Tobbisch/Brewnode/README.md

# Brewnode
Cheap IO node for taking in values to a Siemens PLC
