Tobbisch/Brewnode/Brewnode_PCB/Brewnode_PCB.csv

Source: | C:\Program Files\KiCad\share\kicad\Brewnode\Brewnode_PCB\Brewnode_PCB.sch
Date: | 2020-09-22 17:36:48
Tool: | Eeschema (5.1.6)-1
Generator: | C:\Program Files\KiCad\bin\scripting\plugins/bom_csv_grouped_by_value.py
Component Count: | 83
Individual Components:
Item | Qty | Reference(s) | Value | LibPart | Footprint | Datasheet | LCSC | Mfc
 |  | C1 | 100nF | Device:C | Capacitor_SMD:C_0402_1005Metric | https://datasheet.lcsc.com/szlcsc/1810191219_Samsung-Electro-Mechanics-CL05B104KO5NNNC_C1525.pdf | C1525 | CL05B104KO5NNNC
 |  | C2 | 47uF | Device:C_Polarized | Capacitor_SMD:CP_Elec_6.3x5.3 | https://datasheet.lcsc.com/szlcsc/1912111437_Lelon-VEZ470M1CTR-0605_C249778.pdf | C249778 | VEZ470M1CTR-0605
 |  | C3 | 220uF | Device:C_Polarized | Capacitor_SMD:CP_Elec_8x10 | https://datasheet.lcsc.com/szlcsc/1912111437_Lelon-VUA221M1ATR-0810_C249801.pdf | C249801 | VUA221M1ATR-0810
 |  | C4 | 100nF | Device:C | Capacitor_SMD:C_0402_1005Metric | https://datasheet.lcsc.com/szlcsc/1810191219_Samsung-Electro-Mechanics-CL05B104KO5NNNC_C1525.pdf | C1525 | CL05B104KO5NNNC
 |  | C5 | 47uF | Device:C_Polarized | Capacitor_SMD:CP_Elec_6.3x5.3 | https://datasheet.lcsc.com/szlcsc/1912111437_Lelon-VEZ470M1CTR-0605_C249778.pdf | C249778 | VEZ470M1CTR-0605
 |  | C6 | 47uF | Device:C_Polarized | Capacitor_SMD:CP_Elec_6.3x5.3 | https://datasheet.lcsc.com/szlcsc/1912111437_Lelon-VEZ470M1CTR-0605_C249778.pdf | C249778 | VEZ470M1CTR-0605
 |  | D1 | LED_1206 | Device:LED | LED_SMD:LED_1206_3216Metric | https://datasheet.lcsc.com/szlcsc/1810231512_Lite-On-LTST-C150KGKT_C125085.pdf | C125085 | LTST-C150KGKT
 |  | D2 | LED_1206 | Device:LED | LED_SMD:LED_1206_3216Metric | https://datasheet.lcsc.com/szlcsc/1810231512_Lite-On-LTST-C150KGKT_C125085.pdf | C125085 | LTST-C150KGKT
 |  | D3 | SMA | Device:D | Diode_SMD:D_SMA-SMB_Universal_Handsoldering | https://datasheet.lcsc.com/szlcsc/1810311713_MDD-Microdiode-Electronics-M7_C95872.pdf | C95872 | M7
 |  | D4 | SMA | Device:D | Diode_SMD:D_SMA-SMB_Universal_Handsoldering | https://datasheet.lcsc.com/szlcsc/1810311713_MDD-Microdiode-Electronics-M7_C95872.pdf | C95872 | M7
 |  | D5 | SMA | Device:D | Diode_SMD:D_SMA-SMB_Universal_Handsoldering | https://datasheet.lcsc.com/szlcsc/1810311713_MDD-Microdiode-Electronics-M7_C95872.pdf | C95872 | M7
 |  | D6 | SMA | Device:D | Diode_SMD:D_SMA-SMB_Universal_Handsoldering | https://datasheet.lcsc.com/szlcsc/1810311713_MDD-Microdiode-Electronics-M7_C95872.pdf | C95872 | M7
 |  | F1 | 500mA | Device:Polyfuse_Small | Fuse:Fuse_0402_1005Metric | https://datasheet.lcsc.com/szlcsc/1808141123_Littelfuse-0435-500KRHF_C206945.pdf | C206945 | 0435.500KRHF
 |  | F2 | 500mA | Device:Polyfuse_Small | Fuse:Fuse_0402_1005Metric | https://datasheet.lcsc.com/szlcsc/1808141123_Littelfuse-0435-500KRHF_C206945.pdf | C206945 | 0435.500KRHF
 |  | J1 | Screw_Terminal_01x03 | Connector:Screw_Terminal_01x03 | Connector_Phoenix_MSTB:PhoenixContact_MSTBA_2,5_3-G-5,08_1x03_P5.08mm_Horizontal | https://datasheet.lcsc.com/szlcsc/1912251632_Ningbo-Kangnex-Elec-WJ2EDGRC-5-08-3P_C8377.pdf | C8377 | WJ2EDGRC-5.08-3P
 |  | J2 | Screw_Terminal_01x03 | Connector:Screw_Terminal_01x03 | Connector_Phoenix_MSTB:PhoenixContact_MSTBA_2,5_3-G-5,08_1x03_P5.08mm_Horizontal | https://datasheet.lcsc.com/szlcsc/1912251632_Ningbo-Kangnex-Elec-WJ2EDGRC-5-08-3P_C8377.pdf | C8377 | WJ2EDGRC-5.08-3P
 |  | J3 | Screw_Terminal_01x03 | Connector:Screw_Terminal_01x03 | Connector_Phoenix_MSTB:PhoenixContact_MSTBVA_2,5_3-G-5,08_1x03_P5.08mm_Vertical | https://datasheet.lcsc.com/szlcsc/1912251634_Ningbo-Kangnex-Elec-WJ2EDGVC-5-08-3P_C8412.pdf | C8412 | WJ2EDGVC-5.08-3P
 |  | J4 | Screw_Terminal_01x03 | Connector:Screw_Terminal_01x03 | Connector_Phoenix_MSTB:PhoenixContact_MSTBVA_2,5_3-G-5,08_1x03_P5.08mm_Vertical | https://datasheet.lcsc.com/szlcsc/1912251634_Ningbo-Kangnex-Elec-WJ2EDGVC-5-08-3P_C8412.pdf | C8412 | WJ2EDGVC-5.08-3P
 |  | J5 | Screw_Terminal_01x03 | Connector:Screw_Terminal_01x03 | Connector_Phoenix_MSTB:PhoenixContact_MSTBA_2,5_3-G-5,08_1x03_P5.08mm_Horizontal | https://datasheet.lcsc.com/szlcsc/1912251632_Ningbo-Kangnex-Elec-WJ2EDGRC-5-08-3P_C8377.pdf | C8377 | WJ2EDGRC-5.08-3P
 |  | J6 | Screw_Terminal_01x03 | Connector:Screw_Terminal_01x03 | Connector_Phoenix_MSTB:PhoenixContact_MSTBA_2,5_3-G-5,08_1x03_P5.08mm_Horizontal | https://datasheet.lcsc.com/szlcsc/1912251632_Ningbo-Kangnex-Elec-WJ2EDGRC-5-08-3P_C8377.pdf | C8377 | WJ2EDGRC-5.08-3P
 |  | J7 | Screw_Terminal_01x03 | Connector:Screw_Terminal_01x03 | Connector_Phoenix_MSTB:PhoenixContact_MSTBA_2,5_3-G-5,08_1x03_P5.08mm_Horizontal | https://datasheet.lcsc.com/szlcsc/1912251632_Ningbo-Kangnex-Elec-WJ2EDGRC-5-08-3P_C8377.pdf | C8377 | WJ2EDGRC-5.08-3P
 |  | J8 | Screw_Terminal_01x03 | Connector:Screw_Terminal_01x03 | Connector_Phoenix_MSTB:PhoenixContact_MSTBA_2,5_3-G-5,08_1x03_P5.08mm_Horizontal | https://datasheet.lcsc.com/szlcsc/1912251632_Ningbo-Kangnex-Elec-WJ2EDGRC-5-08-3P_C8377.pdf | C8377 | WJ2EDGRC-5.08-3P
 |  | J9 | Screw_Terminal_01x03 | Connector:Screw_Terminal_01x03 | Connector_Phoenix_MSTB:PhoenixContact_MSTBA_2,5_3-G-5,08_1x03_P5.08mm_Horizontal | https://datasheet.lcsc.com/szlcsc/1912251632_Ningbo-Kangnex-Elec-WJ2EDGRC-5-08-3P_C8377.pdf | C8377 | WJ2EDGRC-5.08-3P
 |  | J10 | Screw_Terminal_01x03 | Connector:Screw_Terminal_01x03 | Connector_Phoenix_MSTB:PhoenixContact_MSTBA_2,5_3-G-5,08_1x03_P5.08mm_Horizontal | https://datasheet.lcsc.com/szlcsc/1912251632_Ningbo-Kangnex-Elec-WJ2EDGRC-5-08-3P_C8377.pdf | C8377 | WJ2EDGRC-5.08-3P
 |  | J11 | Screw_Terminal_01x03 | Connector:Screw_Terminal_01x03 | Connector_Phoenix_MSTB:PhoenixContact_MSTBVA_2,5_3-G-5,08_1x03_P5.08mm_Vertical | https://datasheet.lcsc.com/szlcsc/1912251634_Ningbo-Kangnex-Elec-WJ2EDGVC-5-08-3P_C8412.pdf | C8412 | WJ2EDGVC-5.08-3P
 |  | J12 | Screw_Terminal_01x03 | Connector:Screw_Terminal_01x03 | Connector_Phoenix_MSTB:PhoenixContact_MSTBVA_2,5_3-G-5,08_1x03_P5.08mm_Vertical | https://datasheet.lcsc.com/szlcsc/1912251634_Ningbo-Kangnex-Elec-WJ2EDGVC-5-08-3P_C8412.pdf | C8412 | WJ2EDGVC-5.08-3P
 |  | J13 | Screw_Terminal_01x03 | Connector:Screw_Terminal_01x03 | Connector_Phoenix_MSTB:PhoenixContact_MSTBA_2,5_3-G-5,08_1x03_P5.08mm_Horizontal | https://datasheet.lcsc.com/szlcsc/1912251632_Ningbo-Kangnex-Elec-WJ2EDGRC-5-08-3P_C8377.pdf | C8377 | WJ2EDGRC-5.08-3P
 |  | J14 | Screw_Terminal_01x03 | Connector:Screw_Terminal_01x03 | Connector_Phoenix_MSTB:PhoenixContact_MSTBA_2,5_3-G-5,08_1x03_P5.08mm_Horizontal | https://datasheet.lcsc.com/szlcsc/1912251632_Ningbo-Kangnex-Elec-WJ2EDGRC-5-08-3P_C8377.pdf | C8377 | WJ2EDGRC-5.08-3P
 |  | J15 | Screw_Terminal_01x03 | Connector:Screw_Terminal_01x03 | Connector_Phoenix_MSTB:PhoenixContact_MSTBVA_2,5_3-G-5,08_1x03_P5.08mm_Vertical | https://datasheet.lcsc.com/szlcsc/1912251634_Ningbo-Kangnex-Elec-WJ2EDGVC-5-08-3P_C8412.pdf | C8412 | WJ2EDGVC-5.08-3P
 |  | J16 | Screw_Terminal_01x03 | Connector:Screw_Terminal_01x03 | Connector_Phoenix_MSTB:PhoenixContact_MSTBVA_2,5_3-G-5,08_1x03_P5.08mm_Vertical | https://datasheet.lcsc.com/szlcsc/1912251634_Ningbo-Kangnex-Elec-WJ2EDGVC-5-08-3P_C8412.pdf | C8412 | WJ2EDGVC-5.08-3P
 |  | J17 | 16p FPC | Connector_Generic:Conn_01x16 | Connector_FFC-FPC:Hirose_FH34_FPC_16 | https://datasheet.lcsc.com/szlcsc/1811071030_HRS-Hirose-FH34SRJ-16S-0-5SH-50_C324725.pdf | C324725 | FH34SRJ-16S-0.5SH(50)
 |  | JP1 | Jumper_2_Open | Jumper:Jumper_2_Open | Connector_PinHeader_2.54mm:PinHeader_1x02_P2.54mm_Vertical | ~
 |  | JP2 | Jumper_2_Open | Jumper:Jumper_2_Open | Connector_PinHeader_2.54mm:PinHeader_1x02_P2.54mm_Vertical | ~
 |  | JP3 | Jumper_2_Open | Jumper:Jumper_2_Open | Connector_PinHeader_2.54mm:PinHeader_1x02_P2.54mm_Vertical | ~
 |  | JP4 | Jumper_2_Open | Jumper:Jumper_2_Open | Connector_PinHeader_2.54mm:PinHeader_1x02_P2.54mm_Vertical | ~
 |  | JP5 | Jumper_2_Open | Jumper:Jumper_2_Open | Connector_PinHeader_2.54mm:PinHeader_1x02_P2.54mm_Vertical | ~
 |  | JP6 | Jumper_2_Open | Jumper:Jumper_2_Open | Connector_PinHeader_2.54mm:PinHeader_1x02_P2.54mm_Vertical | ~
 |  | JP7 | Jumper_2_Open | Jumper:Jumper_2_Open | Connector_PinHeader_2.54mm:PinHeader_1x02_P2.54mm_Vertical | ~
 |  | JP8 | Jumper_2_Open | Jumper:Jumper_2_Open | Connector_PinHeader_2.54mm:PinHeader_1x02_P2.54mm_Vertical | ~
 |  | K1 | SANYOU_SRD_Form_C | Relay:SANYOU_SRD_Form_C | Relay_THT:Relay_SPDT_SANYOU_SRD_Series_Form_C | https://datasheet.lcsc.com/szlcsc/1811021933_Ningbo-Songle-Relay-SRD-05VDC-SL-C_C35449.pdf | C35449 | SRD-05VDC-SL-C
 |  | K2 | SANYOU_SRD_Form_C | Relay:SANYOU_SRD_Form_C | Relay_THT:Relay_SPDT_SANYOU_SRD_Series_Form_C | https://datasheet.lcsc.com/szlcsc/1811021933_Ningbo-Songle-Relay-SRD-05VDC-SL-C_C35449.pdf | C35449 | SRD-05VDC-SL-C
 |  | K3 | SANYOU_SRD_Form_C | Relay:SANYOU_SRD_Form_C | Relay_THT:Relay_SPDT_SANYOU_SRD_Series_Form_C | https://datasheet.lcsc.com/szlcsc/1811021933_Ningbo-Songle-Relay-SRD-05VDC-SL-C_C35449.pdf | C35449 | SRD-05VDC-SL-C
 |  | K4 | SANYOU_SRD_Form_C | Relay:SANYOU_SRD_Form_C | Relay_THT:Relay_SPDT_SANYOU_SRD_Series_Form_C | https://datasheet.lcsc.com/szlcsc/1811021933_Ningbo-Songle-Relay-SRD-05VDC-SL-C_C35449.pdf | C35449 | SRD-05VDC-SL-C
 |  | Q1 | FDN340P | Transistor_FET:FDN340P | Package_TO_SOT_SMD:SOT-23 | https://www.onsemi.com/pub/Collateral/FDN340P-D.PDF | C75469 | FDN340P
 |  | Q2 | FDN340P | Transistor_FET:FDN340P | Package_TO_SOT_SMD:SOT-23 | https://www.onsemi.com/pub/Collateral/FDN340P-D.PDF | C75469 | FDN340P
 |  | Q3 | FDN340P | Transistor_FET:FDN340P | Package_TO_SOT_SMD:SOT-23 | https://www.onsemi.com/pub/Collateral/FDN340P-D.PDF | C75469 | FDN340P
 |  | Q4 | FDN340P | Transistor_FET:FDN340P | Package_TO_SOT_SMD:SOT-23 | https://www.onsemi.com/pub/Collateral/FDN340P-D.PDF | C75469 | FDN340P
 |  | Q5 | BSS138 | Transistor_FET:BSS138 | Package_TO_SOT_SMD:SOT-23 | https://www.onsemi.com/pub/Collateral/BSS138-D.PDF | C52895 | BSS138
 |  | Q6 | BSS138 | Transistor_FET:BSS138 | Package_TO_SOT_SMD:SOT-23 | https://www.onsemi.com/pub/Collateral/BSS138-D.PDF | C52895 | BSS138
 |  | Q7 | BSS138 | Transistor_FET:BSS138 | Package_TO_SOT_SMD:SOT-23 | https://www.onsemi.com/pub/Collateral/BSS138-D.PDF | C52895 | BSS138
 |  | Q8 | BSS138 | Transistor_FET:BSS138 | Package_TO_SOT_SMD:SOT-23 | https://www.onsemi.com/pub/Collateral/BSS138-D.PDF | C52895 | BSS138
 |  | R1 | 220Ohm | Device:R | Resistor_SMD:R_0805_2012Metric_Pad1.15x1.40mm_HandSolder | https://datasheet.lcsc.com/szlcsc/1810241809_UNI-ROYAL-Uniroyal-Elec-0805W8F2200T5E_C17557.pdf | C17557 | 0805W8F2200T5E
 |  | R2 | 100Ohm | Device:R | Resistor_SMD:R_0805_2012Metric_Pad1.15x1.40mm_HandSolder | https://datasheet.lcsc.com/szlcsc/1809062111_UNI-ROYAL-Uniroyal-Elec-0805W8F1000T5E_C17408.pdf | C17408 | 0805W8F1000T5E
 |  | R3 | 10kOhm | Device:R | Resistor_SMD:R_0805_2012Metric_Pad1.15x1.40mm_HandSolder | https://datasheet.lcsc.com/szlcsc/1810271610_UNI-ROYAL-Uniroyal-Elec-0805W8F1002T5E_C17414.pdf | C17414 | 0805W8F1002T5E
 |  | R4 | 10kOhm | Device:R | Resistor_SMD:R_0805_2012Metric_Pad1.15x1.40mm_HandSolder | https://datasheet.lcsc.com/szlcsc/1810271610_UNI-ROYAL-Uniroyal-Elec-0805W8F1002T5E_C17414.pdf | C17414 | 0805W8F1002T5E
 |  | R5 | 10kOhm | Device:R | Resistor_SMD:R_0805_2012Metric_Pad1.15x1.40mm_HandSolder | https://datasheet.lcsc.com/szlcsc/1810271610_UNI-ROYAL-Uniroyal-Elec-0805W8F1002T5E_C17414.pdf | C17414 | 0805W8F1002T5E
 |  | R6 | 10kOhm | Device:R | Resistor_SMD:R_0805_2012Metric_Pad1.15x1.40mm_HandSolder | https://datasheet.lcsc.com/szlcsc/1810271610_UNI-ROYAL-Uniroyal-Elec-0805W8F1002T5E_C17414.pdf | C17414 | 0805W8F1002T5E
 |  | R7 | 8.2kOhm | Device:R | Resistor_SMD:R_0805_2012Metric_Pad1.15x1.40mm_HandSolder | https://datasheet.lcsc.com/szlcsc/1912111437_UNI-ROYAL-Uniroyal-Elec-0805W8D8201T5E_C407435.pdf | C407435 | 0805W8D8201T5E
 |  | R8 | 8.2kOhm | Device:R | Resistor_SMD:R_0805_2012Metric_Pad1.15x1.40mm_HandSolder | https://datasheet.lcsc.com/szlcsc/1912111437_UNI-ROYAL-Uniroyal-Elec-0805W8D8201T5E_C407435.pdf | C407435 | 0805W8D8201T5E
 |  | R9 | 8.2kOhm | Device:R | Resistor_SMD:R_0805_2012Metric_Pad1.15x1.40mm_HandSolder | https://datasheet.lcsc.com/szlcsc/1912111437_UNI-ROYAL-Uniroyal-Elec-0805W8D8201T5E_C407435.pdf | C407435 | 0805W8D8201T5E
 |  | R10 | 8.2kOhm | Device:R | Resistor_SMD:R_0805_2012Metric_Pad1.15x1.40mm_HandSolder | https://datasheet.lcsc.com/szlcsc/1912111437_UNI-ROYAL-Uniroyal-Elec-0805W8D8201T5E_C407435.pdf | C407435 | 0805W8D8201T5E
 |  | R11 | 8.2kOhm | Device:R | Resistor_SMD:R_0805_2012Metric_Pad1.15x1.40mm_HandSolder | https://datasheet.lcsc.com/szlcsc/1912111437_UNI-ROYAL-Uniroyal-Elec-0805W8D8201T5E_C407435.pdf | C407435 | 0805W8D8201T5E
 |  | R12 | 8.2kOhm | Device:R | Resistor_SMD:R_0805_2012Metric_Pad1.15x1.40mm_HandSolder | https://datasheet.lcsc.com/szlcsc/1912111437_UNI-ROYAL-Uniroyal-Elec-0805W8D8201T5E_C407435.pdf | C407435 | 0805W8D8201T5E
 |  | R13 | 8.2kOhm | Device:R | Resistor_SMD:R_0805_2012Metric_Pad1.15x1.40mm_HandSolder | https://datasheet.lcsc.com/szlcsc/1912111437_UNI-ROYAL-Uniroyal-Elec-0805W8D8201T5E_C407435.pdf | C407435 | 0805W8D8201T5E
 |  | R14 | 8.2kOhm | Device:R | Resistor_SMD:R_0805_2012Metric_Pad1.15x1.40mm_HandSolder | https://datasheet.lcsc.com/szlcsc/1912111437_UNI-ROYAL-Uniroyal-Elec-0805W8D8201T5E_C407435.pdf | C407435 | 0805W8D8201T5E
 |  | R15 | 10kOhm | Device:R | Resistor_SMD:R_0805_2012Metric_Pad1.15x1.40mm_HandSolder | https://datasheet.lcsc.com/szlcsc/1810271610_UNI-ROYAL-Uniroyal-Elec-0805W8F1002T5E_C17414.pdf | C17414 | 0805W8F1002T5E
 |  | R16 | 10kOhm | Device:R | Resistor_SMD:R_0805_2012Metric_Pad1.15x1.40mm_HandSolder | https://datasheet.lcsc.com/szlcsc/1810271610_UNI-ROYAL-Uniroyal-Elec-0805W8F1002T5E_C17414.pdf | C17414 | 0805W8F1002T5E
 |  | R17 | 10kOhm | Device:R | Resistor_SMD:R_0805_2012Metric_Pad1.15x1.40mm_HandSolder | https://datasheet.lcsc.com/szlcsc/1810271610_UNI-ROYAL-Uniroyal-Elec-0805W8F1002T5E_C17414.pdf | C17414 | 0805W8F1002T5E
 |  | R18 | 10kOhm | Device:R | Resistor_SMD:R_0805_2012Metric_Pad1.15x1.40mm_HandSolder | https://datasheet.lcsc.com/szlcsc/1810271610_UNI-ROYAL-Uniroyal-Elec-0805W8F1002T5E_C17414.pdf | C17414 | 0805W8F1002T5E
 |  | R19 | 10kOhm | Device:R | Resistor_SMD:R_0805_2012Metric_Pad1.15x1.40mm_HandSolder | https://datasheet.lcsc.com/szlcsc/1810271610_UNI-ROYAL-Uniroyal-Elec-0805W8F1002T5E_C17414.pdf | C17414 | 0805W8F1002T5E
 |  | R20 | 10kOhm | Device:R | Resistor_SMD:R_0805_2012Metric_Pad1.15x1.40mm_HandSolder | https://datasheet.lcsc.com/szlcsc/1810271610_UNI-ROYAL-Uniroyal-Elec-0805W8F1002T5E_C17414.pdf | C17414 | 0805W8F1002T5E
 |  | R21 | 10kOhm | Device:R | Resistor_SMD:R_0805_2012Metric_Pad1.15x1.40mm_HandSolder | https://datasheet.lcsc.com/szlcsc/1810271610_UNI-ROYAL-Uniroyal-Elec-0805W8F1002T5E_C17414.pdf | C17414 | 0805W8F1002T5E
 |  | R22 | 10kOhm | Device:R | Resistor_SMD:R_0805_2012Metric_Pad1.15x1.40mm_HandSolder | https://datasheet.lcsc.com/szlcsc/1810271610_UNI-ROYAL-Uniroyal-Elec-0805W8F1002T5E_C17414.pdf | C17414 | 0805W8F1002T5E
 |  | R23 | 4.7kOhm | Device:R | Resistor_SMD:R_0805_2012Metric_Pad1.15x1.40mm_HandSolder | https://datasheet.lcsc.com/szlcsc/1808281533_UNI-ROYAL-Uniroyal-Elec-0805W8F4701T5E_C17673.pdf | C17673 | 0805W8F4701T5E
 |  | R24 | 4.7kOhm | Device:R | Resistor_SMD:R_0805_2012Metric_Pad1.15x1.40mm_HandSolder | https://datasheet.lcsc.com/szlcsc/1808281533_UNI-ROYAL-Uniroyal-Elec-0805W8F4701T5E_C17673.pdf | C17673 | 0805W8F4701T5E
 |  | R25 | 4.7kOhm | Device:R | Resistor_SMD:R_0805_2012Metric_Pad1.15x1.40mm_HandSolder | https://datasheet.lcsc.com/szlcsc/1808281533_UNI-ROYAL-Uniroyal-Elec-0805W8F4701T5E_C17673.pdf | C17673 | 0805W8F4701T5E
 |  | R26 | 4.7kOhm | Device:R | Resistor_SMD:R_0805_2012Metric_Pad1.15x1.40mm_HandSolder | https://datasheet.lcsc.com/szlcsc/1808281533_UNI-ROYAL-Uniroyal-Elec-0805W8F4701T5E_C17673.pdf | C17673 | 0805W8F4701T5E
 |  | R27 | 10kOhm | Device:R | Resistor_SMD:R_0805_2012Metric_Pad1.15x1.40mm_HandSolder | https://datasheet.lcsc.com/szlcsc/1810271610_UNI-ROYAL-Uniroyal-Elec-0805W8F1002T5E_C17414.pdf | C17414 | 0805W8F1002T5E
 |  | R28 | 10kOhm | Device:R | Resistor_SMD:R_0805_2012Metric_Pad1.15x1.40mm_HandSolder | https://datasheet.lcsc.com/szlcsc/1810271610_UNI-ROYAL-Uniroyal-Elec-0805W8F1002T5E_C17414.pdf | C17414 | 0805W8F1002T5E
 |  | R29 | 10kOhm | Device:R | Resistor_SMD:R_0805_2012Metric_Pad1.15x1.40mm_HandSolder | https://datasheet.lcsc.com/szlcsc/1810271610_UNI-ROYAL-Uniroyal-Elec-0805W8F1002T5E_C17414.pdf | C17414 | 0805W8F1002T5E
 |  | R30 | 10kOhm | Device:R | Resistor_SMD:R_0805_2012Metric_Pad1.15x1.40mm_HandSolder | https://datasheet.lcsc.com/szlcsc/1810271610_UNI-ROYAL-Uniroyal-Elec-0805W8F1002T5E_C17414.pdf | C17414 | 0805W8F1002T5E
 |  | U1 | PCF8574 | Interface_Expansion:PCF8574 | Package_SO:SOIC-16W_7.5x10.3mm_P1.27mm | https://datasheet.lcsc.com/szlcsc/1809261711_NXP-Semicon-PCF8574T-3-518_C7605.pdf | C7605 | PCF8574T/3,518
 |  | U2 | ADS1115IDGS | Analog_ADC:ADS1115IDGS | Package_SO:VSSOP-10_3x3mm_P0.5mm | https://datasheet.lcsc.com/szlcsc/1809192322_Texas-Instruments-ADS1115IDGSR_C37593.pdf | C37593 | ADS1115IDGSR
Collated Components:
Item | Qty | Reference(s) | Value | LibPart | Footprint | Datasheet | LCSC | Mfc
1 | 2 | C1, C4 | 100nF | Device:C | Capacitor_SMD:C_0402_1005Metric | https://datasheet.lcsc.com/szlcsc/1810191219_Samsung-Electro-Mechanics-CL05B104KO5NNNC_C1525.pdf | C1525 | CL05B104KO5NNNC
2 | 3 | C2, C5, C6 | 47uF | Device:C_Polarized | Capacitor_SMD:CP_Elec_6.3x5.3 | https://datasheet.lcsc.com/szlcsc/1912111437_Lelon-VEZ470M1CTR-0605_C249778.pdf | C249778 | VEZ470M1CTR-0605
3 | 1 | C3 | 220uF | Device:C_Polarized | Capacitor_SMD:CP_Elec_8x10 | https://datasheet.lcsc.com/szlcsc/1912111437_Lelon-VUA221M1ATR-0810_C249801.pdf | C249801 | VUA221M1ATR-0810
4 | 2 | D1, D2 | LED_1206 | Device:LED | LED_SMD:LED_1206_3216Metric | https://datasheet.lcsc.com/szlcsc/1810231512_Lite-On-LTST-C150KGKT_C125085.pdf | C125085 | LTST-C150KGKT
5 | 4 | D3, D4, D5, D6 | SMA | Device:D | Diode_SMD:D_SMA-SMB_Universal_Handsoldering | https://datasheet.lcsc.com/szlcsc/1810311713_MDD-Microdiode-Electronics-M7_C95872.pdf | C95872 | M7
6 | 2 | F1, F2 | 500mA | Device:Polyfuse_Small | Fuse:Fuse_0402_1005Metric | https://datasheet.lcsc.com/szlcsc/1808141123_Littelfuse-0435-500KRHF_C206945.pdf | C206945 | 0435.500KRHF
7 | 10 | J1, J2, J5, J6, J7, J8, J9, J10, J13, J14 | Screw_Terminal_01x03 | Connector:Screw_Terminal_01x03 | Connector_Phoenix_MSTB:PhoenixContact_MSTBA_2,5_3-G-5,08_1x03_P5.08mm_Horizontal | https://datasheet.lcsc.com/szlcsc/1912251632_Ningbo-Kangnex-Elec-WJ2EDGRC-5-08-3P_C8377.pdf | C8377 | WJ2EDGRC-5.08-3P
8 | 6 | J3, J4, J11, J12, J15, J16 | Screw_Terminal_01x03 | Connector:Screw_Terminal_01x03 | Connector_Phoenix_MSTB:PhoenixContact_MSTBVA_2,5_3-G-5,08_1x03_P5.08mm_Vertical | https://datasheet.lcsc.com/szlcsc/1912251634_Ningbo-Kangnex-Elec-WJ2EDGVC-5-08-3P_C8412.pdf | C8412 | WJ2EDGVC-5.08-3P
9 | 1 | J17 | 16p FPC | Connector_Generic:Conn_01x16 | Connector_FFC-FPC:Hirose_FH34_FPC_16 | https://datasheet.lcsc.com/szlcsc/1811071030_HRS-Hirose-FH34SRJ-16S-0-5SH-50_C324725.pdf | C324725 | FH34SRJ-16S-0.5SH(50)
10 | 8 | JP1, JP2, JP3, JP4, JP5, JP6, JP7, JP8 | Jumper_2_Open | Jumper:Jumper_2_Open | Connector_PinHeader_2.54mm:PinHeader_1x02_P2.54mm_Vertical | ~
11 | 4 | K1, K2, K3, K4 | SANYOU_SRD_Form_C | Relay:SANYOU_SRD_Form_C | Relay_THT:Relay_SPDT_SANYOU_SRD_Series_Form_C | https://datasheet.lcsc.com/szlcsc/1811021933_Ningbo-Songle-Relay-SRD-05VDC-SL-C_C35449.pdf | C35449 | SRD-05VDC-SL-C
12 | 4 | Q1, Q2, Q3, Q4 | FDN340P | Transistor_FET:FDN340P | Package_TO_SOT_SMD:SOT-23 | https://www.onsemi.com/pub/Collateral/FDN340P-D.PDF | C75469 | FDN340P
13 | 4 | Q5, Q6, Q7, Q8 | BSS138 | Transistor_FET:BSS138 | Package_TO_SOT_SMD:SOT-23 | https://www.onsemi.com/pub/Collateral/BSS138-D.PDF | C52895 | BSS138
14 | 1 | R1 | 220Ohm | Device:R | Resistor_SMD:R_0805_2012Metric_Pad1.15x1.40mm_HandSolder | https://datasheet.lcsc.com/szlcsc/1810241809_UNI-ROYAL-Uniroyal-Elec-0805W8F2200T5E_C17557.pdf | C17557 | 0805W8F2200T5E
15 | 1 | R2 | 100Ohm | Device:R | Resistor_SMD:R_0805_2012Metric_Pad1.15x1.40mm_HandSolder | https://datasheet.lcsc.com/szlcsc/1809062111_UNI-ROYAL-Uniroyal-Elec-0805W8F1000T5E_C17408.pdf | C17408 | 0805W8F1000T5E
16 | 16 | R3, R4, R5, R6, R15, R16, R17, R18, R19, R20, R21, R22, R27, R28, R29, R30 | 10kOhm | Device:R | Resistor_SMD:R_0805_2012Metric_Pad1.15x1.40mm_HandSolder | https://datasheet.lcsc.com/szlcsc/1810271610_UNI-ROYAL-Uniroyal-Elec-0805W8F1002T5E_C17414.pdf | C17414 | 0805W8F1002T5E
17 | 8 | R7, R8, R9, R10, R11, R12, R13, R14 | 8.2kOhm | Device:R | Resistor_SMD:R_0805_2012Metric_Pad1.15x1.40mm_HandSolder | https://datasheet.lcsc.com/szlcsc/1912111437_UNI-ROYAL-Uniroyal-Elec-0805W8D8201T5E_C407435.pdf | C407435 | 0805W8D8201T5E
18 | 4 | R23, R24, R25, R26 | 4.7kOhm | Device:R | Resistor_SMD:R_0805_2012Metric_Pad1.15x1.40mm_HandSolder | https://datasheet.lcsc.com/szlcsc/1808281533_UNI-ROYAL-Uniroyal-Elec-0805W8F4701T5E_C17673.pdf | C17673 | 0805W8F4701T5E
19 | 1 | U1 | PCF8574 | Interface_Expansion:PCF8574 | Package_SO:SOIC-16W_7.5x10.3mm_P1.27mm | https://datasheet.lcsc.com/szlcsc/1809261711_NXP-Semicon-PCF8574T-3-518_C7605.pdf | C7605 | PCF8574T/3,518
20 | 1 | U2 | ADS1115IDGS | Analog_ADC:ADS1115IDGS | Package_SO:VSSOP-10_3x3mm_P0.5mm | https://datasheet.lcsc.com/szlcsc/1809192322_Texas-Instruments-ADS1115IDGSR_C37593.pdf | C37593 | ADS1115IDGSR
