Tobbisch/Brewnode/Brewnode_PCB/Brewnode_PCB.kicad_pcb

## KiCad design Brewnode_PCB/Brewnode_PCB.kicad_pcb (2020-10-15)

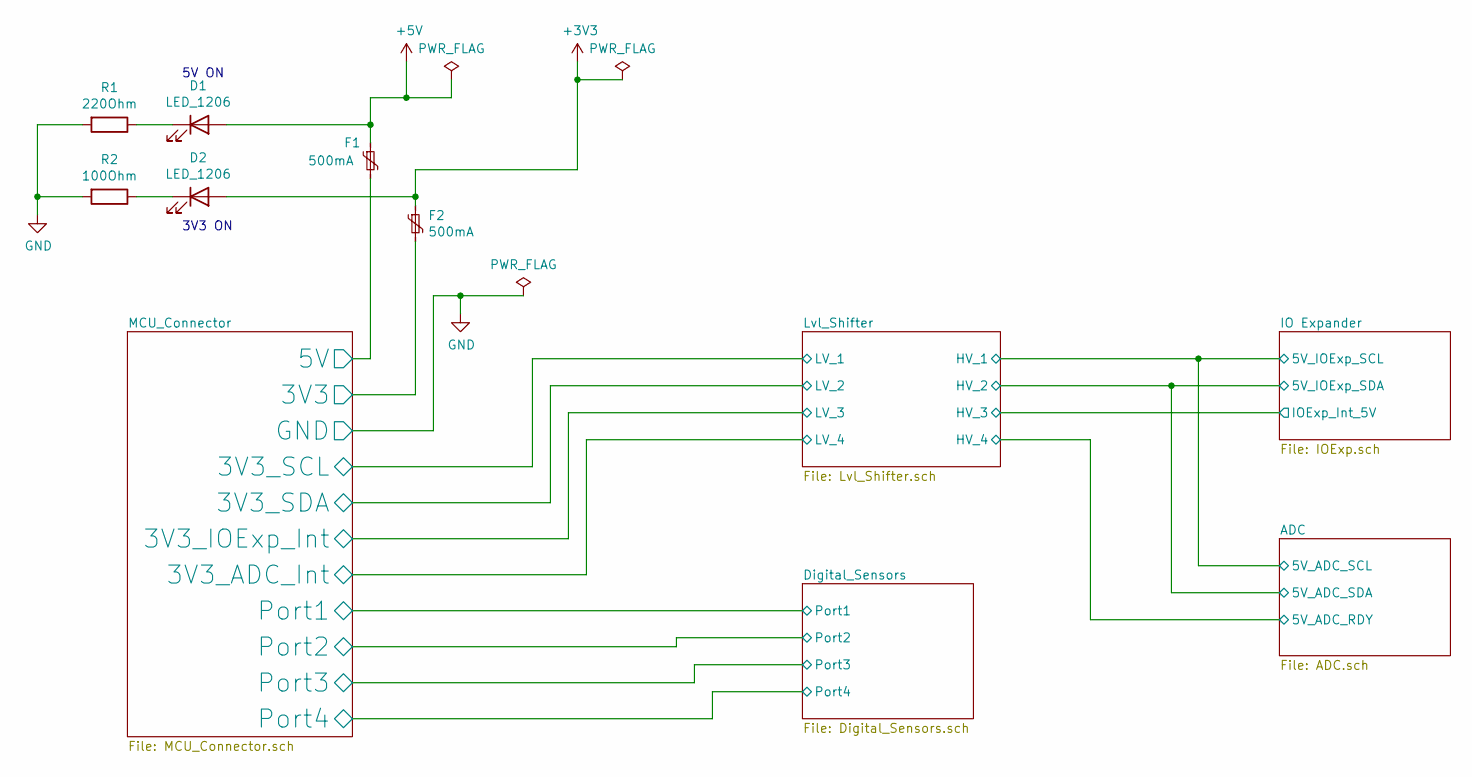
[picture p1: schematic Brewnode_PCB.sch, BrewnodeV1]

Parts:
D1, D2: LED_1206; LED_1206_3216Metric; LCSC C125085
F1, F2: 500mA; Fuse_0402_1005Metric; LCSC C206945
R1: 220Ohm; R_0805_2012Metric_Pad1.15x1.40mm_HandSolder; LCSC C17557
R2: 100Ohm; R_0805_2012Metric_Pad1.15x1.40mm_HandSolder; LCSC C17408

Connections:
+3V3: D2.2 (A), F2.1; also elsewhere on the board
+5V: D1.2 (A), F1.1; also elsewhere on the board
/MCU_Connector/3V3: F2.2; also elsewhere on the board
/MCU_Connector/5V: F1.2; also elsewhere on the board
GND: R1.2, R2.2; also elsewhere on the board
unnamed: D1.1 (K), R1.1
unnamed: D2.1 (K), R2.1

Notes on the sheet:
5V ON
3V3 ON

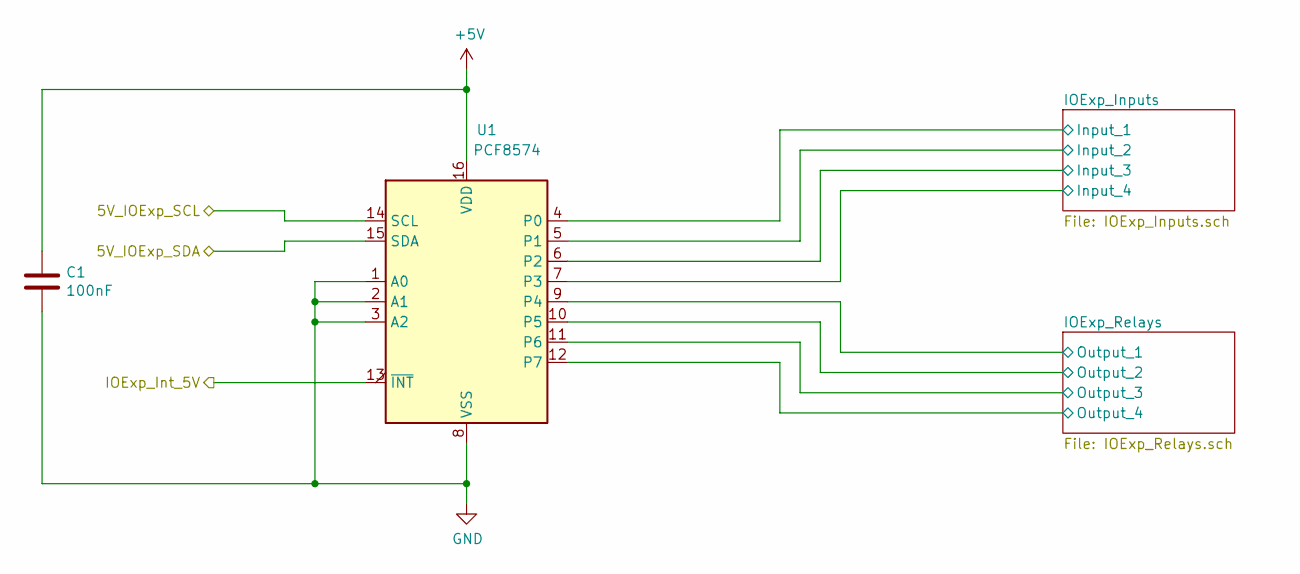
[picture p2: schematic IOExp.sch, BrewnodeV1]

Parts:
C1: 100nF; C_0402_1005Metric; LCSC C1525
U1: PCF8574; SOIC-16W_7.5x10.3mm_P1.27mm; LCSC C7605

Connections:
+5V: C1.1, U1.16 (VDD); also elsewhere on the board
/ADC/5V_ADC_SCL: U1.14 (SCL); also elsewhere on the board
/ADC/5V_ADC_SDA: U1.15 (SDA); also elsewhere on the board
/IO Expander/IOExp_Inputs/Input_1: U1.4 (P0); also elsewhere on the board
/IO Expander/IOExp_Inputs/Input_2: U1.5 (P1); also elsewhere on the board
/IO Expander/IOExp_Inputs/Input_3: U1.6 (P2); also elsewhere on the board
/IO Expander/IOExp_Inputs/Input_4: U1.7 (P3); also elsewhere on the board
/IO Expander/IOExp_Relays/Output_1: U1.9 (P4); also elsewhere on the board
/IO Expander/IOExp_Relays/Output_2: U1.10 (P5); also elsewhere on the board
/IO Expander/IOExp_Relays/Output_3: U1.11 (P6); also elsewhere on the board
/IO Expander/IOExp_Relays/Output_4: U1.12 (P7); also elsewhere on the board
/Lvl_Shifter/HV_3: U1.13 (~INT~); also elsewhere on the board
GND: C1.2, U1.1 (A0), U1.2 (A1), U1.3 (A2), U1.8 (VSS); also elsewhere on the board

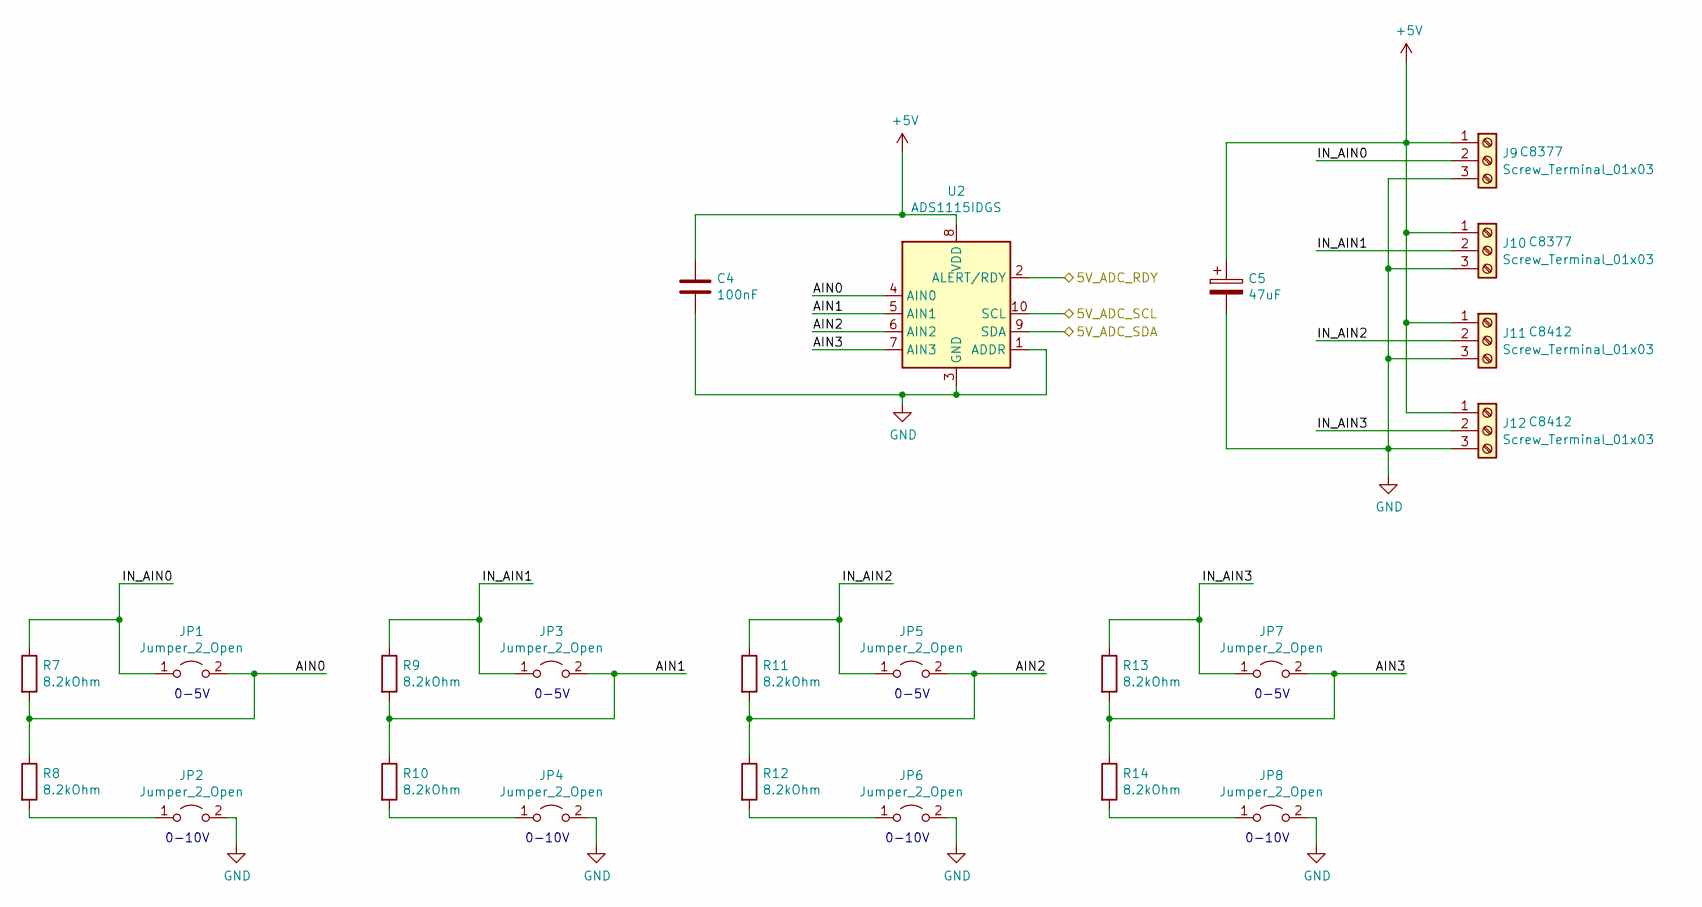
[picture p3: schematic ADC.sch, BrewnodeV1]

Parts:
C4: 100nF; C_0402_1005Metric; LCSC C1525
C5: 47uF; CP_Elec_6.3x5.3; LCSC C249778
J9, J10: Screw_Terminal_01x03; PhoenixContact_MSTBA_2,5_3-G-5,08_1x03_P5.08mm_Horizontal; LCSC C8377
J11, J12: Screw_Terminal_01x03; PhoenixContact_MSTBVA_2,5_3-G-5,08_1x03_P5.08mm_Vertical; LCSC C8412
JP1, JP2, JP3, JP4, JP5, JP6, JP7, JP8: Jumper_2_Open; PinHeader_1x02_P2.54mm_Vertical
R7, R8, R9, R10, R11, R12, R13, R14: 8.2kOhm; R_0805_2012Metric_Pad1.15x1.40mm_HandSolder; LCSC C407435
U2: ADS1115IDGS; VSSOP-10_3x3mm_P0.5mm; LCSC C37593

Connections:
+5V: C4.1, C5.1, J9.1, J10.1, J11.1, J12.1, U2.8 (VDD); also elsewhere on the board
/ADC/5V_ADC_RDY: U2.2 (ALERT/RDY); also elsewhere on the board
/ADC/5V_ADC_SCL: U2.10 (SCL); also elsewhere on the board
/ADC/5V_ADC_SDA: U2.9 (SDA); also elsewhere on the board
/ADC/AIN0: JP1.2 (B), R7.2, R8.1, U2.4 (AIN0)
/ADC/AIN1: JP3.2 (B), R9.2, R10.1, U2.5 (AIN1)
/ADC/AIN2: JP5.2 (B), R11.2, R12.1, U2.6 (AIN2)
/ADC/AIN3: JP7.2 (B), R13.2, R14.1, U2.7 (AIN3)
/ADC/IN_AIN0: J9.2, JP1.1 (A), R7.1
/ADC/IN_AIN1: J10.2, JP3.1 (A), R9.1
/ADC/IN_AIN2: J11.2, JP5.1 (A), R11.1
/ADC/IN_AIN3: J12.2, JP7.1 (A), R13.1
GND: C4.2, C5.2, J9.3, J10.3, J11.3, J12.3, JP2.2 (B), JP4.2 (B), JP6.2 (B), JP8.2 (B), U2.1 (ADDR), U2.3 (GND); also elsewhere on the board
unnamed: JP2.1 (A), R8.2
unnamed: JP4.1 (A), R10.2
unnamed: JP6.1 (A), R12.2
unnamed: JP8.1 (A), R14.2

Notes on the sheet:
0-5V
0-10V

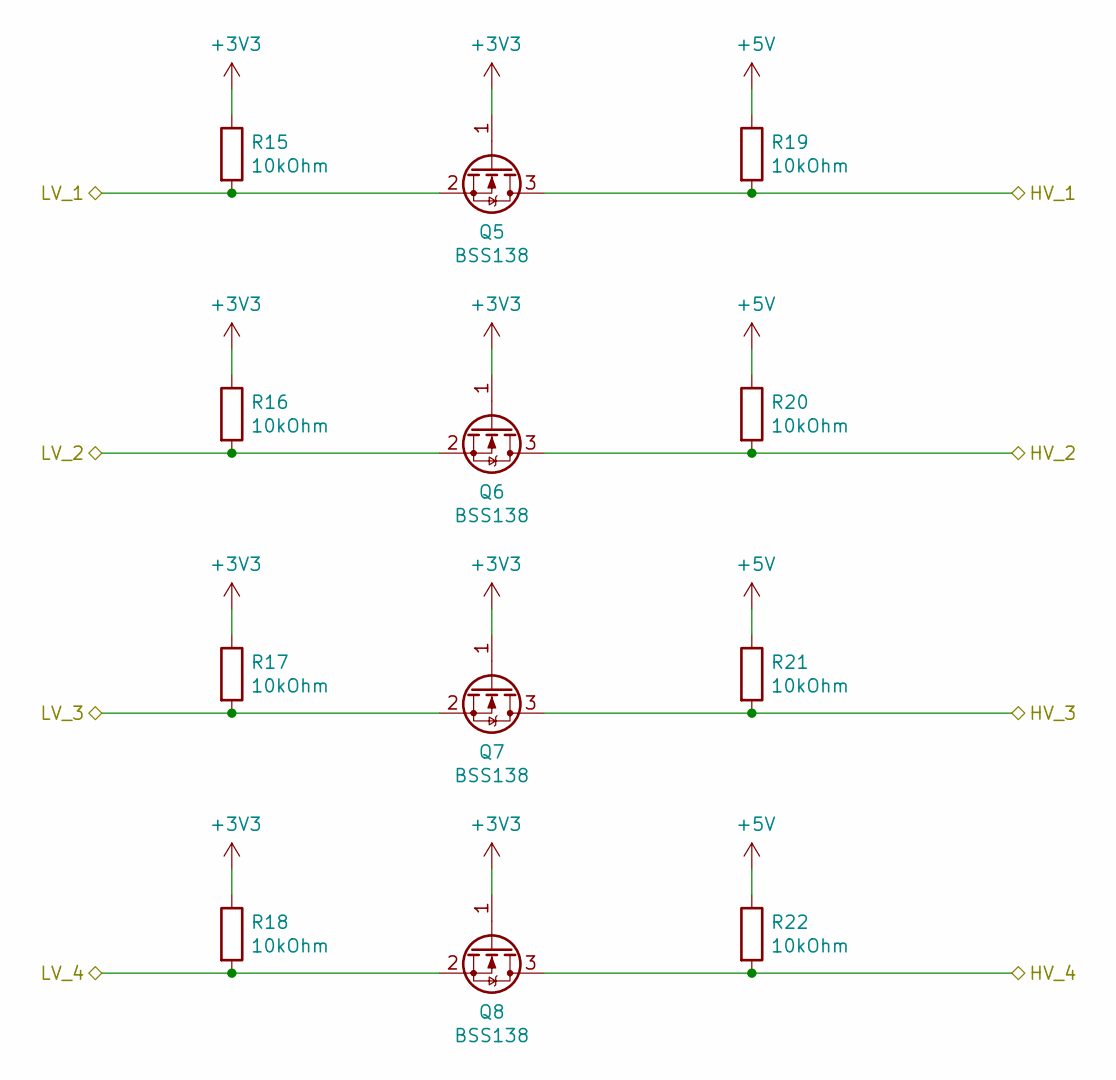
[picture p4: schematic Lvl_Shifter.sch, BrewnodeV1]

Parts:
Q5, Q6, Q7, Q8: BSS138; SOT-23; LCSC C52895
R15, R16, R17, R18, R19, R20, R21, R22: 10kOhm; R_0805_2012Metric_Pad1.15x1.40mm_HandSolder; LCSC C17414

Connections:
+3V3: Q5.1 (G), Q6.1 (G), Q7.1 (G), Q8.1 (G), R15.1, R16.1, R17.1, R18.1; also elsewhere on the board
+5V: R19.1, R20.1, R21.1, R22.1; also elsewhere on the board
/ADC/5V_ADC_RDY: Q8.3 (D), R22.2; also elsewhere on the board
/ADC/5V_ADC_SCL: Q5.3 (D), R19.2; also elsewhere on the board
/ADC/5V_ADC_SDA: Q6.3 (D), R20.2; also elsewhere on the board
/Lvl_Shifter/HV_3: Q7.3 (D), R21.2; also elsewhere on the board
/MCU_Connector/3V3_ADC_Int: Q8.2 (S), R18.2; also elsewhere on the board
/MCU_Connector/3V3_IOExp_Int: Q7.2 (S), R17.2; also elsewhere on the board
/MCU_Connector/3V3_SCL: Q5.2 (S), R15.2; also elsewhere on the board
/MCU_Connector/3V3_SDA: Q6.2 (S), R16.2; also elsewhere on the board

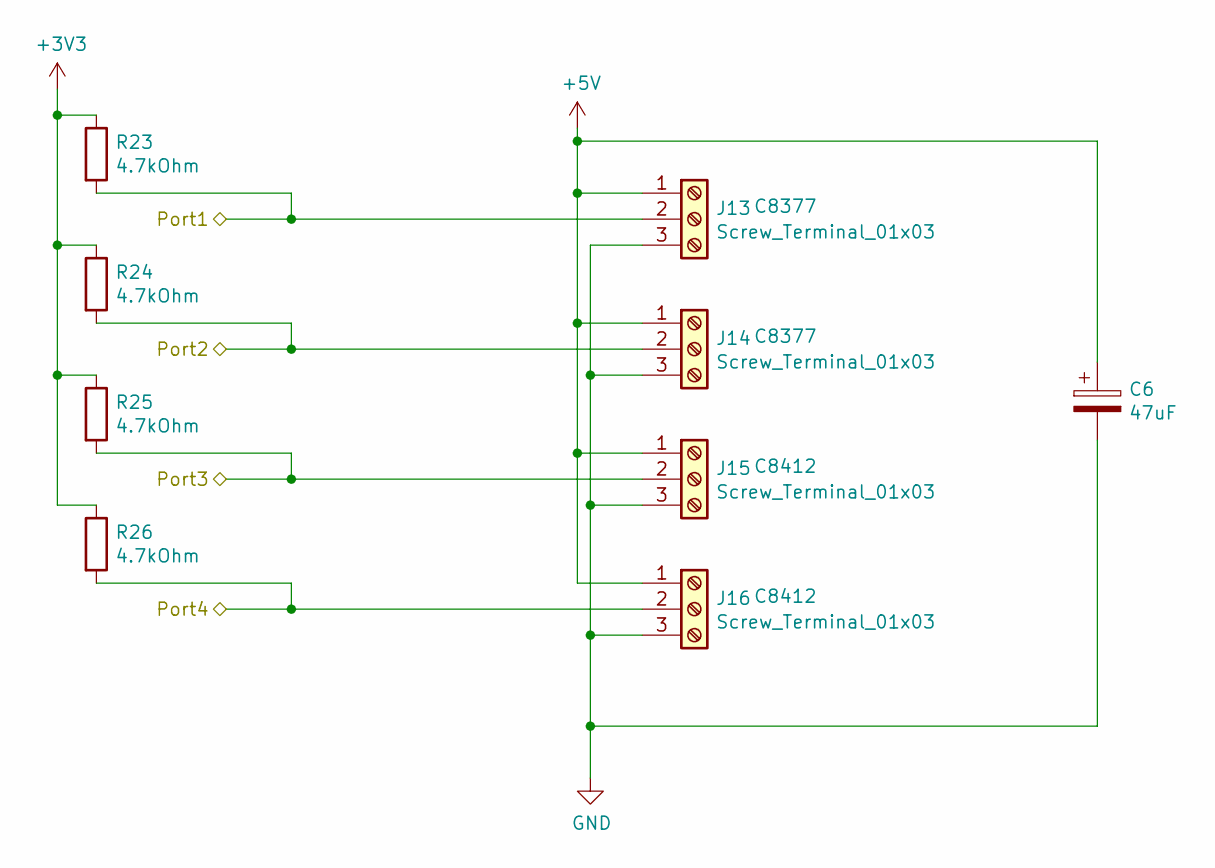
[picture p5: schematic Digital_Sensors.sch, BrewnodeV1]

Parts:
C6: 47uF; CP_Elec_6.3x5.3; LCSC C249778
J13, J14: Screw_Terminal_01x03; PhoenixContact_MSTBA_2,5_3-G-5,08_1x03_P5.08mm_Horizontal; LCSC C8377
J15, J16: Screw_Terminal_01x03; PhoenixContact_MSTBVA_2,5_3-G-5,08_1x03_P5.08mm_Vertical; LCSC C8412
R23, R24, R25, R26: 4.7kOhm; R_0805_2012Metric_Pad1.15x1.40mm_HandSolder; LCSC C17673

Connections:
+3V3: R23.1, R24.1, R25.1, R26.1; also elsewhere on the board
+5V: C6.1, J13.1, J14.1, J15.1, J16.1; also elsewhere on the board
/Digital_Sensors/Port1: J13.2, R23.2; also elsewhere on the board
/Digital_Sensors/Port2: J14.2, R24.2; also elsewhere on the board
/Digital_Sensors/Port3: J15.2, R25.2; also elsewhere on the board
/Digital_Sensors/Port4: J16.2, R26.2; also elsewhere on the board
GND: C6.2, J13.3, J14.3, J15.3, J16.3; also elsewhere on the board

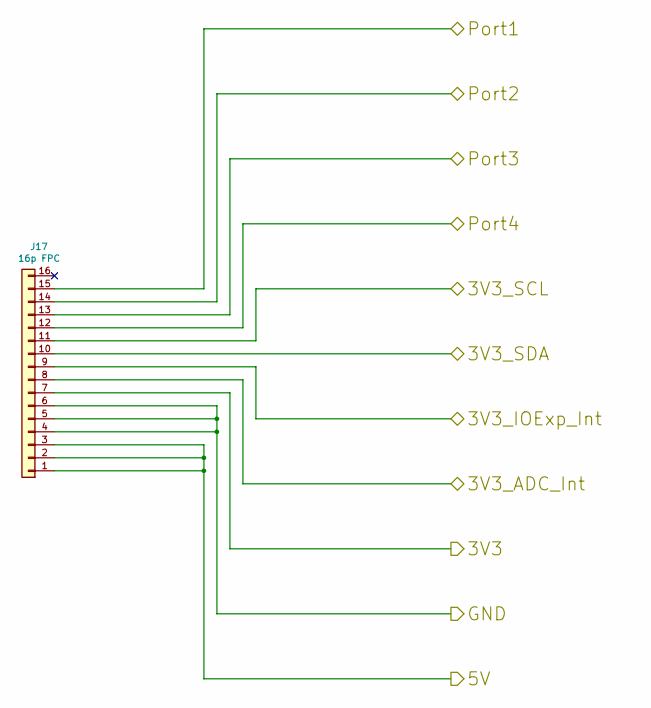
[picture p6: schematic MCU_Connector.sch, BrewnodeV1]

Parts:
J17: 16p FPC; Hirose_FH34_FPC_16; LCSC C324725

Connections:
/Digital_Sensors/Port1: J17.15; also elsewhere on the board
/Digital_Sensors/Port2: J17.14; also elsewhere on the board
/Digital_Sensors/Port3: J17.13; also elsewhere on the board
/Digital_Sensors/Port4: J17.12; also elsewhere on the board
/MCU_Connector/3V3: J17.7; also elsewhere on the board
/MCU_Connector/3V3_ADC_Int: J17.8; also elsewhere on the board
/MCU_Connector/3V3_IOExp_Int: J17.9; also elsewhere on the board
/MCU_Connector/3V3_SCL: J17.11; also elsewhere on the board
/MCU_Connector/3V3_SDA: J17.10; also elsewhere on the board
/MCU_Connector/5V: J17.1, J17.2, J17.3; also elsewhere on the board
GND: J17.4, J17.5, J17.6; also elsewhere on the board

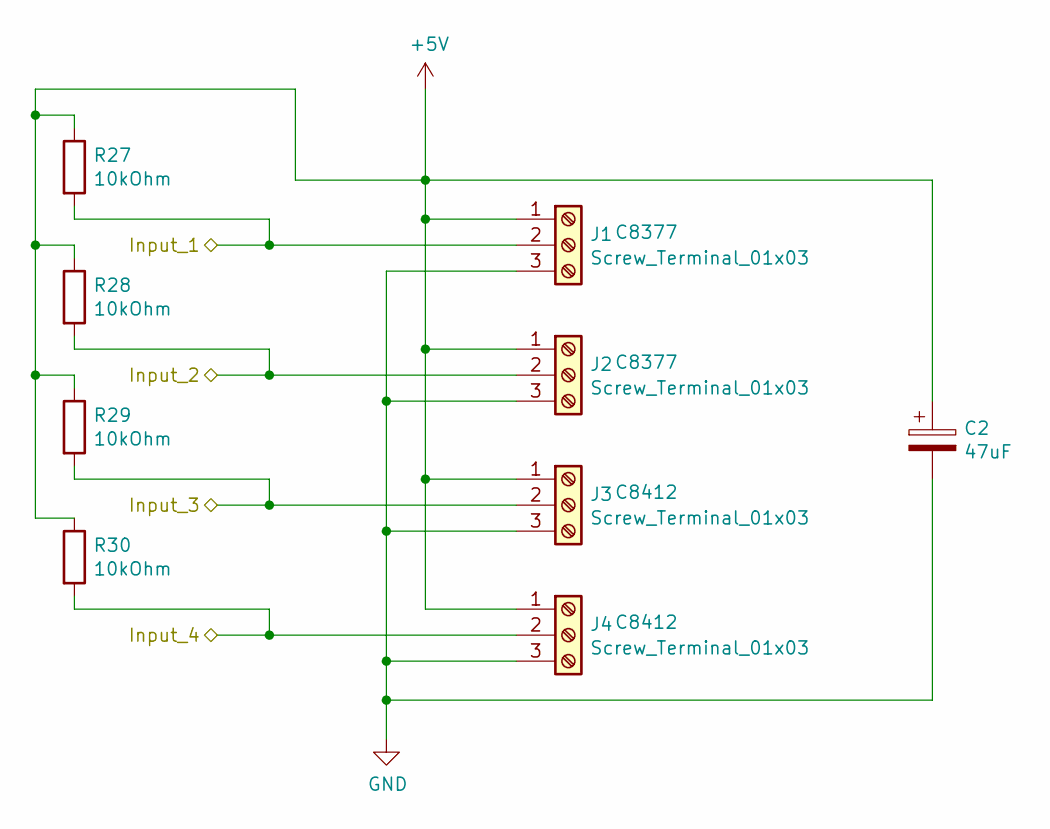
[picture p7: schematic IOExp_Inputs.sch, BrewnodeV1]

Parts:
C2: 47uF; CP_Elec_6.3x5.3; LCSC C249778
J1, J2: Screw_Terminal_01x03; PhoenixContact_MSTBA_2,5_3-G-5,08_1x03_P5.08mm_Horizontal; LCSC C8377
J3, J4: Screw_Terminal_01x03; PhoenixContact_MSTBVA_2,5_3-G-5,08_1x03_P5.08mm_Vertical; LCSC C8412
R27, R28, R29, R30: 10kOhm; R_0805_2012Metric_Pad1.15x1.40mm_HandSolder; LCSC C17414

Connections:
+5V: C2.1, J1.1, J2.1, J3.1, J4.1, R27.1, R28.1, R29.1, R30.1; also elsewhere on the board
/IO Expander/IOExp_Inputs/Input_1: J1.2, R27.2; also elsewhere on the board
/IO Expander/IOExp_Inputs/Input_2: J2.2, R28.2; also elsewhere on the board
/IO Expander/IOExp_Inputs/Input_3: J3.2, R29.2; also elsewhere on the board
/IO Expander/IOExp_Inputs/Input_4: J4.2, R30.2; also elsewhere on the board
GND: C2.2, J1.3, J2.3, J3.3, J4.3; also elsewhere on the board

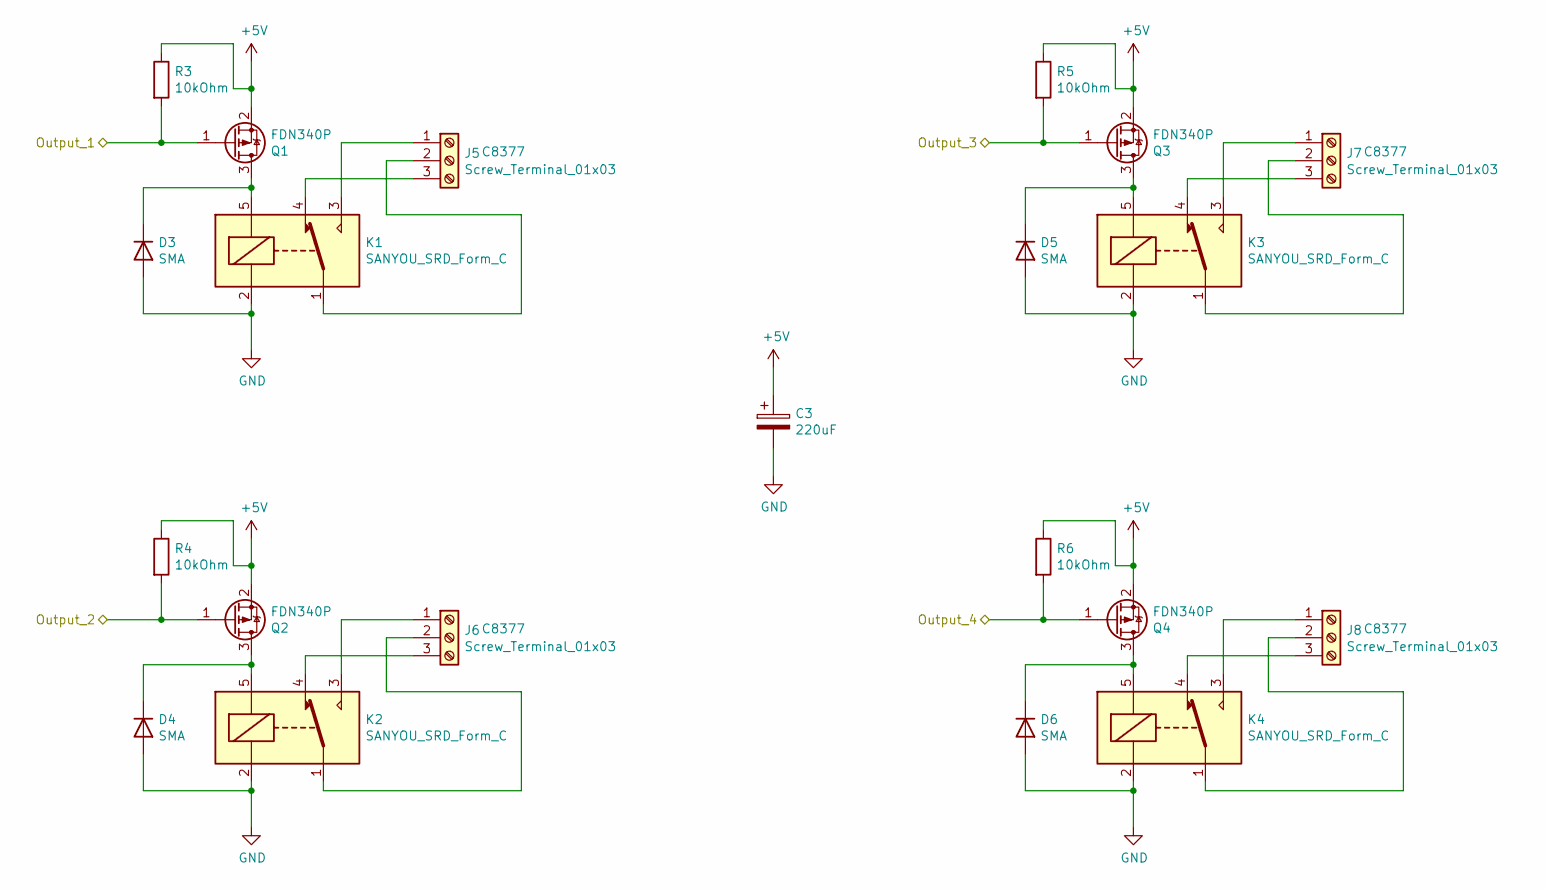
[picture p8: schematic IOExp_Relays.sch, BrewnodeV1]

Parts:
C3: 220uF; CP_Elec_8x10; LCSC C249801
D3, D4, D5, D6: SMA; D_SMA-SMB_Universal_Handsoldering; LCSC C95872
J5, J6, J7, J8: Screw_Terminal_01x03; PhoenixContact_MSTBA_2,5_3-G-5,08_1x03_P5.08mm_Horizontal; LCSC C8377
K1, K2, K3, K4: SANYOU_SRD_Form_C; Relay_SPDT_SANYOU_SRD_Series_Form_C; LCSC C35449
Q1, Q2, Q3, Q4: FDN340P; SOT-23; LCSC C75469
R3, R4, R5, R6: 10kOhm; R_0805_2012Metric_Pad1.15x1.40mm_HandSolder; LCSC C17414

Connections:
+5V: C3.1, Q1.2 (S), Q2.2 (S), Q3.2 (S), Q4.2 (S), R3.1, R4.1, R5.1, R6.1; also elsewhere on the board
/IO Expander/IOExp_Relays/Output_1: Q1.1 (G), R3.2; also elsewhere on the board
/IO Expander/IOExp_Relays/Output_2: Q2.1 (G), R4.2; also elsewhere on the board
/IO Expander/IOExp_Relays/Output_3: Q3.1 (G), R5.2; also elsewhere on the board
/IO Expander/IOExp_Relays/Output_4: Q4.1 (G), R6.2; also elsewhere on the board
GND: C3.2, D3.2 (A), D4.2 (A), D5.2 (A), D6.2 (A), K1.2, K2.2, K3.2, K4.2; also elsewhere on the board
unnamed: D3.1 (K), K1.5, Q1.3 (D)
unnamed: D4.1 (K), K2.5, Q2.3 (D)
unnamed: D5.1 (K), K3.5, Q3.3 (D)
unnamed: D6.1 (K), K4.5, Q4.3 (D)
unnamed: J5.1, K1.3
unnamed: J5.2, K1.1
unnamed: J5.3, K1.4
unnamed: J6.1, K2.3
unnamed: J6.2, K2.1
unnamed: J6.3, K2.4
unnamed: J7.1, K3.3
unnamed: J7.2, K3.1
unnamed: J7.3, K3.4
unnamed: J8.1, K4.3
unnamed: J8.2, K4.1
unnamed: J8.3, K4.4

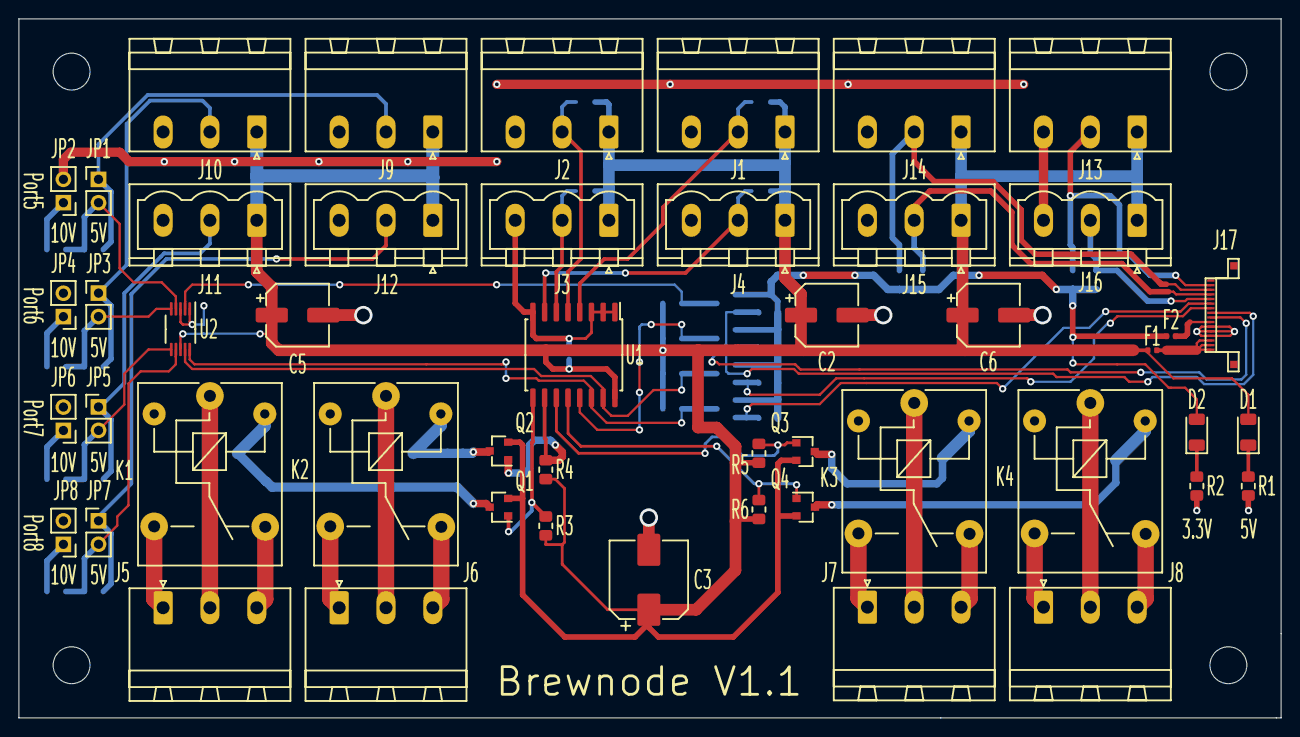
[picture p9: board Brewnode_PCB.kicad_pcb from above]

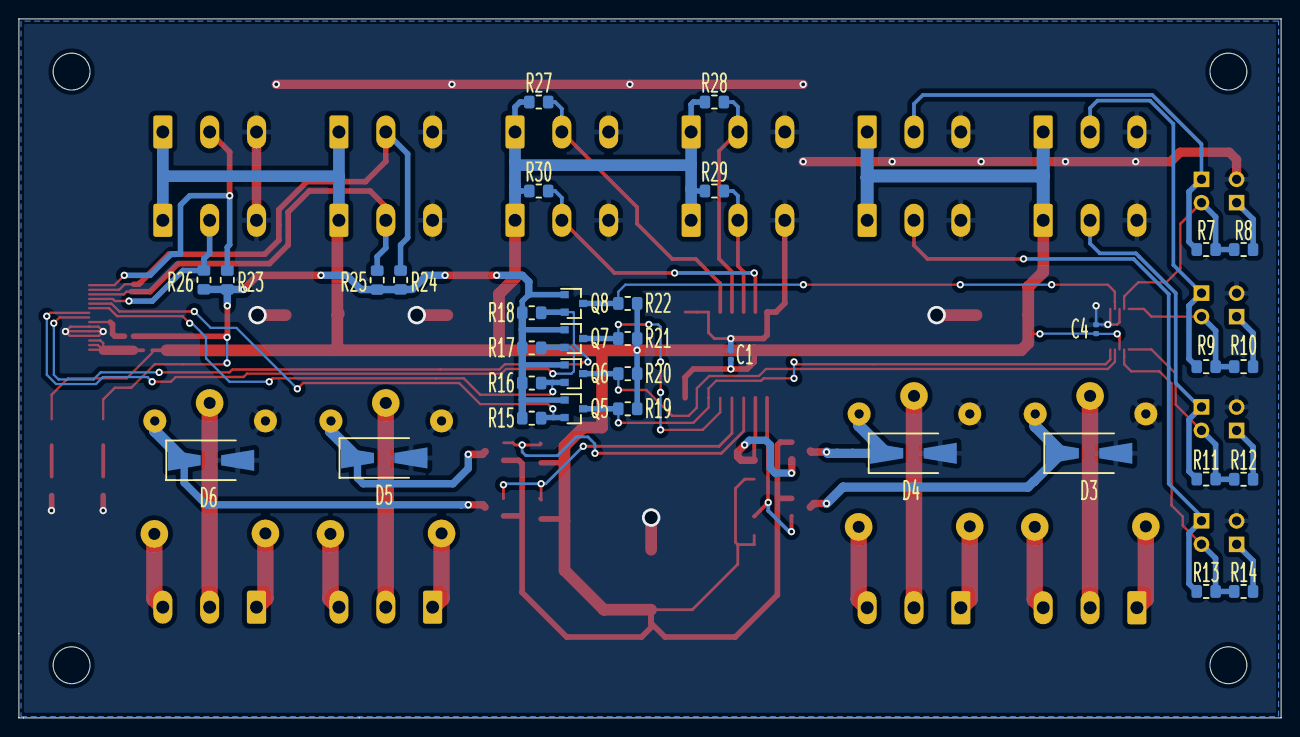
[picture p10: board Brewnode_PCB.kicad_pcb from below]

Board: 2 copper layers, 136.9 x 75.8 mm, 83 parts (34 on the bottom side), 55 nets.
