Tobbisch/Brewnode/(commit log)

2020-09-14 Added PCB
    [Brewnode_PCB.kicad_pcb, Brewnode_PCB.sch]
2020-09-14 PCB Work
    [IOExp.sch, IOExp_Inputs.sch, IOExp_Relays.sch]
2020-09-14 More PCB Work
    [ADC.sch, Brewnode_PCB.sch, IOExp.sch, IOExp_Inputs.sch, IOExp_Relays.sch]
2020-09-15 More PCB Sch work
    [ADC.sch, Brewnode_PCB.sch, Digital_Sensors.sch, IOExp.sch, IOExp_Inputs.sch, IOExp_Relays.sch, Lvl_Shifter.sch]
2020-09-17 Done PCB Sch Work
    [ADC.sch, Brewnode_PCB.csv, Brewnode_PCB.sch, Digital_Sensors.sch, IOExp.sch, IOExp_Inputs.sch, IOExp_Relays.sch, Lvl_Shifter.sch]
2020-09-18 More PCB Pcb work
    [ADC.sch, Brewnode_PCB.kicad_pcb, Brewnode_PCB.sch, Digital_Sensors.sch, IOExp_Inputs.sch, IOExp_Relays.sch]
2020-09-21 PCB V1 To production
    [Brewnode_PCB-B_Cu.gbl, Brewnode_PCB-B_Mask.gbs, Brewnode_PCB-B_SilkS.gbo, Brewnode_PCB-Edge_Cuts.gm1, Brewnode_PCB-F_Cu.gtl, Brewnode_PCB-F_Mask.gts, Brewnode_PCB-F_SilkS.gto, Brewnode_PCB-NPTH.drl]
2020-09-22 PCB_V1 Sent to production
    [Brewnode_PCB-B_Cu.gbl, Brewnode_PCB-B_Mask.gbs, Brewnode_PCB-B_SilkS.gbo, Brewnode_PCB-Edge_Cuts.gm1, Brewnode_PCB-F_Cu.gtl, Brewnode_PCB-F_Mask.gts, Brewnode_PCB-F_SilkS.gto, Brewnode_PCB-NPTH.drl]
2020-09-24 PCB Corrected library
    [MCU_Connector.sch]
2020-10-15 Sch + PCB V1.1
    Corrected FDN340 P-FET Pinout.
    Added 5V, 3V3 Description in silkscreen for indication D1, D2
    [ADC.sch, Brewnode_PCB.kicad_pcb, Brewnode_PCB.sch, Digital_Sensors.sch, IOExp.sch, IOExp_Inputs.sch, IOExp_Relays.sch, Lvl_Shifter.sch]
